Taliayaya/4-bit-alu/alu.kicad_pcb

## KiCad design alu.kicad_pcb (2026-04-29)

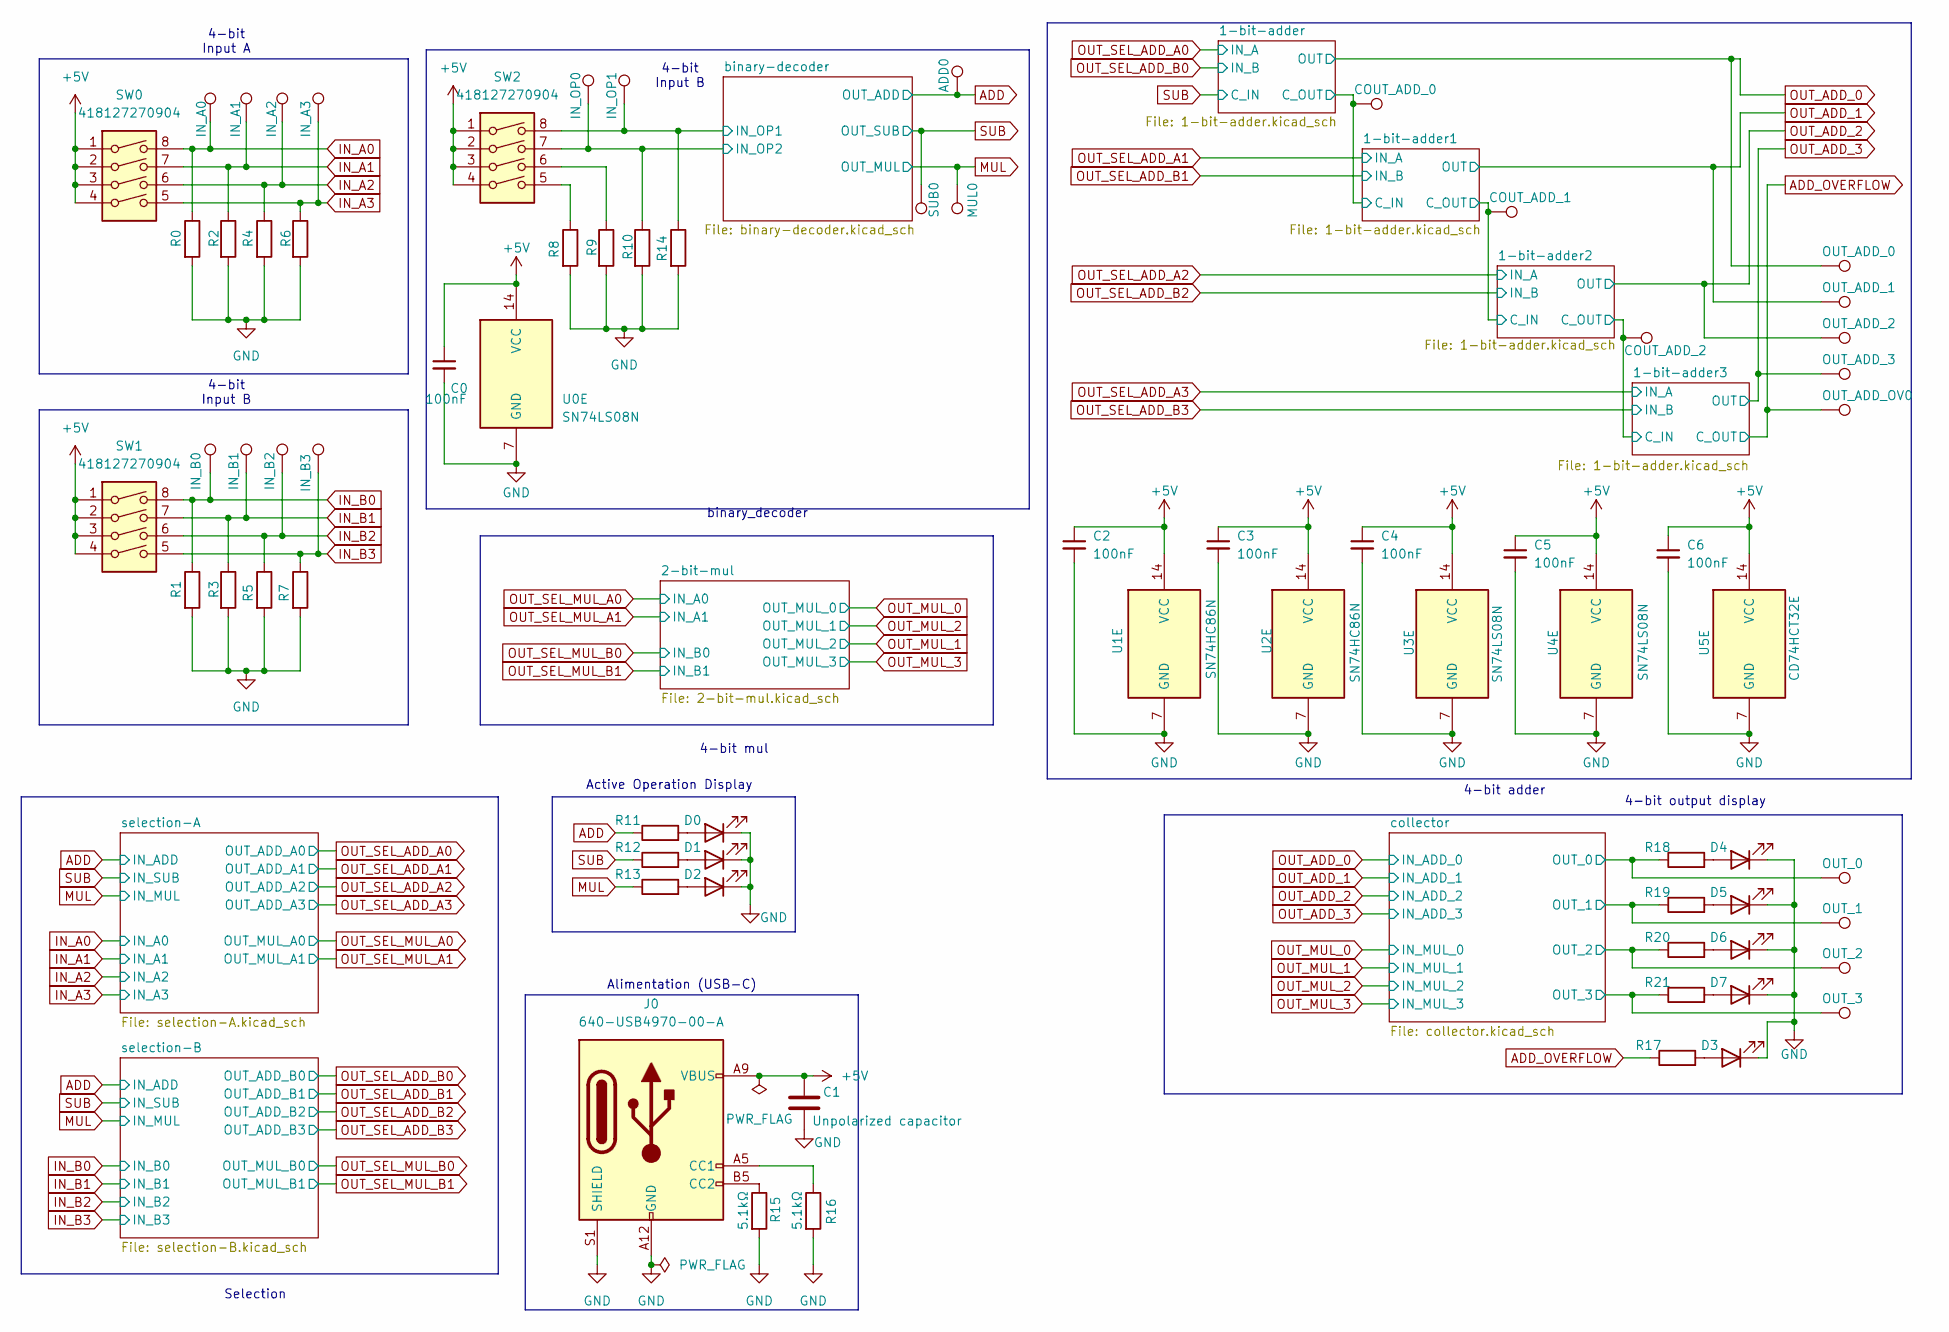
[picture p1: schematic alu.kicad_sch, ALU 4-bit]

Parts:
ADD0: TestPoint; TestPoint_THTPad_D1.0mm_Drill0.5mm
C0, C2, C3, C4, C5, C6: 100nF; C_0603_1608Metric
C1: 10uF; C_0603_1608Metric_Pad1.08x0.95mm_HandSolder
COUT_ADD_0, COUT_ADD_1, COUT_ADD_2: TestPoint; TestPoint_THTPad_D1.0mm_Drill0.5mm
D0, D1, D2, D3, D4, D5, D6, D7: 150080RS75000; LED_0805_2012Metric
IN_A0, IN_A1, IN_A2, IN_A3: TestPoint; TestPoint_THTPad_D1.0mm_Drill0.5mm
IN_B0, IN_B1, IN_B2, IN_B3: TestPoint; TestPoint_THTPad_D1.0mm_Drill0.5mm
IN_OP0, IN_OP1: TestPoint; TestPoint_THTPad_D1.0mm_Drill0.5mm
J0: 640-USB4970-00-A; USB_C_Receptacle_GCT_USB4125-xx-x_6P_TopMnt_Horizontal
MUL0: TestPoint; TestPoint_THTPad_D1.0mm_Drill0.5mm
OUT_0, OUT_1, OUT_2, OUT_3: TestPoint; TestPoint_THTPad_D1.0mm_Drill0.5mm
OUT_ADD_0, OUT_ADD_1, OUT_ADD_2, OUT_ADD_3: TestPoint; TestPoint_THTPad_D1.0mm_Drill0.5mm
OUT_ADD_OV0: TestPoint; TestPoint_THTPad_D1.0mm_Drill0.5mm
R0, R1, R2, R3, R4, R5, R6, R7, R8, R9, R10, R14: 10kΩ; R_0603_1608Metric_Pad0.98x0.95mm_HandSolder
R11, R12, R13, R17, R18, R19, R20, R21: 220Ω; R_0603_1608Metric_Pad0.98x0.95mm_HandSolder
R15, R16: 5.1kΩ; R_0603_1608Metric_Pad0.98x0.95mm_HandSolder
SUB0: TestPoint; TestPoint_THTPad_D1.0mm_Drill0.5mm
SW0, SW1, SW2: 418127270904; SW_DIP_SPSTx04_Slide_6.7x11.72mm_W7.62mm_P2.54mm_LowProfile
U0, U3, U4: SN74LS08N; DIP-14_W7.62mm_LongPads
U1, U2: SN74HC86N; DIP-14_W7.62mm_LongPads
U5: CD74HCT32E; DIP-14_W7.62mm_LongPads

Connections:
+5V: C0.1, C1.1, C2.1, C3.1, C4.1, C5.1, C6.1, J0.A9 (VBUS), J0.B9 (VBUS), SW0.1, SW0.2, SW0.3, SW0.4, SW1.1, SW1.2, SW1.3, SW1.4, SW2.1, SW2.2, SW2.3, SW2.4, U0.14 (VCC), U1.14 (VCC), U2.14 (VCC), U3.14 (VCC), U4.14 (VCC), U5.14 (VCC); also elsewhere on the board
/1-bit-adder1/C_OUT: COUT_ADD_1.1, U5.6; also elsewhere on the board
/1-bit-adder2/C_OUT: COUT_ADD_2.1, U2.13, U3.12, U5.8
/1-bit-adder/C_OUT: COUT_ADD_0.1, U0.12, U1.13; also elsewhere on the board
/binary-decoder/IN_OP1: IN_OP1.1, R14.1, SW2.8; also elsewhere on the board
/binary-decoder/IN_OP2: IN_OP0.1, R10.1, SW2.7; also elsewhere on the board
/collector/OUT_0: OUT_0.1, R18.1; also elsewhere on the board
/collector/OUT_1: OUT_1.1, R19.1; also elsewhere on the board
/collector/OUT_2: OUT_2.1, R20.1; also elsewhere on the board
/collector/OUT_3: OUT_3.1, R21.1; also elsewhere on the board
ADD: ADD0.1, R11.1; also elsewhere on the board
ADD_OVERFLOW: OUT_ADD_OV0.1, R17.1, U5.11
GND: C0.2, C1.2, C2.2, C3.2, C4.2, C5.2, C6.2, D0.1 (K), D1.1 (K), D2.1 (K), D3.1 (K), D4.1 (K), D5.1 (K), D6.1 (K), D7.1 (K), J0.A12 (GND), J0.B12 (GND), J0.S1 (SHIELD), R0.2, R1.2, R2.2, R3.2, R4.2, R5.2, R6.2, R7.2, R8.2, R9.2, R10.2, R14.2, R15.2, R16.2, U0.7 (GND), U1.7 (GND), U2.7 (GND), U3.7 (GND), U4.7 (GND), U5.7 (GND); also elsewhere on the board
IN_A0: IN_A0.1, R0.1, SW0.8; also elsewhere on the board
IN_A1: IN_A1.1, R2.1, SW0.7; also elsewhere on the board
IN_A2: IN_A2.1, R4.1, SW0.6; also elsewhere on the board
IN_A3: IN_A3.1, R6.1, SW0.5; also elsewhere on the board
IN_B0: IN_B0.1, R1.1, SW1.8; also elsewhere on the board
IN_B1: IN_B1.1, R3.1, SW1.7; also elsewhere on the board
IN_B2: IN_B2.1, R5.1, SW1.6; also elsewhere on the board
IN_B3: IN_B3.1, R7.1, SW1.5; also elsewhere on the board
MUL: MUL0.1, R13.1; also elsewhere on the board
unnamed: D0.2 (A), R11.2
unnamed: D1.2 (A), R12.2
unnamed: D2.2 (A), R13.2
unnamed: D3.2 (A), R17.2
unnamed: D4.2 (A), R18.2
unnamed: D5.2 (A), R19.2
unnamed: D6.2 (A), R20.2
unnamed: D7.2 (A), R21.2
unnamed: J0.A5 (CC1), R16.1
unnamed: J0.B5 (CC2), R15.1
unnamed: R8.1, SW2.5
unnamed: R9.1, SW2.6
unnamed: U0.8, U5.4
unnamed: U0.11, U5.5
unnamed: U0.13, U1.8, U1.12
unnamed: U2.8, U2.12, U3.13
unnamed 48: U5.9; also elsewhere on the board
unnamed 49: U5.10; also elsewhere on the board
unnamed: U3.8, U5.12
unnamed: U3.11, U5.13
OUT_ADD_0: OUT_ADD_0.1; also elsewhere on the board
OUT_ADD_1: OUT_ADD_1.1, U1.11; also elsewhere on the board
OUT_ADD_2: OUT_ADD_2.1; also elsewhere on the board
OUT_ADD_3: OUT_ADD_3.1, U2.11; also elsewhere on the board
OUT_SEL_ADD_A1: U0.9, U1.9; also elsewhere on the board
OUT_SEL_ADD_A3: U2.9, U3.9; also elsewhere on the board
OUT_SEL_ADD_B1: U0.10, U1.10; also elsewhere on the board
OUT_SEL_ADD_B3: U2.10, U3.10; also elsewhere on the board
SUB: R12.1, SUB0.1; also elsewhere on the board

Notes on the sheet:
Alimentation (USB-C)
4-bit output display
Active Operation Display
4-bit Input A
Selection
4-bit Input B
4-bit mul
binary_decoder
4-bit adder

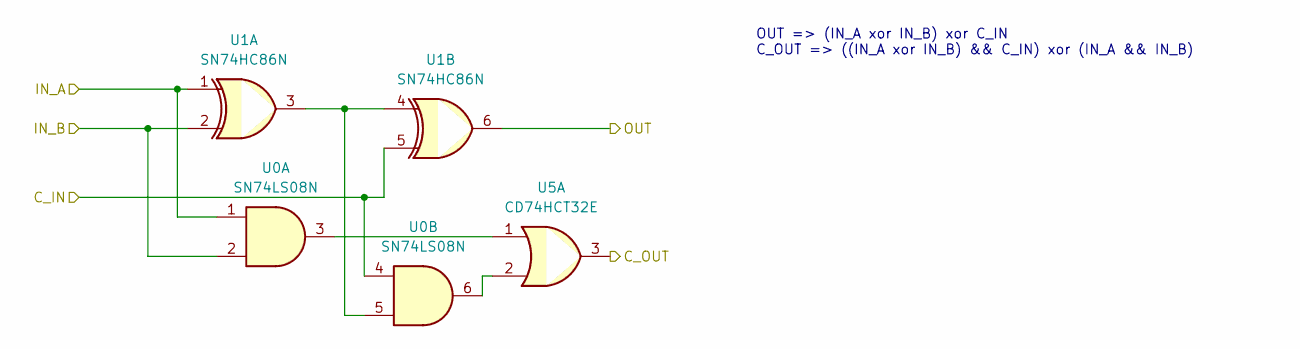
[picture p2: schematic 1-bit-adder.kicad_sch]

Parts:
U0: SN74LS08N; DIP-14_W7.62mm_LongPads
U1: SN74HC86N; DIP-14_W7.62mm_LongPads
U5: CD74HCT32E; DIP-14_W7.62mm_LongPads

Connections:
/1-bit-adder1/C_OUT: U5.6; also elsewhere on the board
/1-bit-adder2/C_OUT: U5.8; also elsewhere on the board
/1-bit-adder/C_OUT: U0.12, U1.13, U5.3; also elsewhere on the board
ADD_OVERFLOW: U5.11; also elsewhere on the board
unnamed: U0.3, U5.1
unnamed: U0.5, U1.3, U1.4
unnamed: U0.6, U5.2
unnamed: U0.8, U5.4
unnamed: U0.11, U5.5
unnamed: U0.13, U1.8, U1.12
unnamed 48: U5.9; also elsewhere on the board
unnamed 49: U5.10; also elsewhere on the board
unnamed 50: U5.12; also elsewhere on the board
unnamed 51: U5.13; also elsewhere on the board
OUT_ADD_0: U1.6; also elsewhere on the board
OUT_ADD_1: U1.11; also elsewhere on the board
OUT_SEL_ADD_A0: U0.1, U1.1; also elsewhere on the board
OUT_SEL_ADD_A1: U0.9, U1.9; also elsewhere on the board
OUT_SEL_ADD_B0: U0.2, U1.2; also elsewhere on the board
OUT_SEL_ADD_B1: U0.10, U1.10; also elsewhere on the board
SUB: U0.4, U1.5; also elsewhere on the board

Notes on the sheet:
OUT => (IN_A xor IN_B) xor C_IN C_OUT => ((IN_A xor IN_B) && C_IN) xor (IN_A && IN_B)

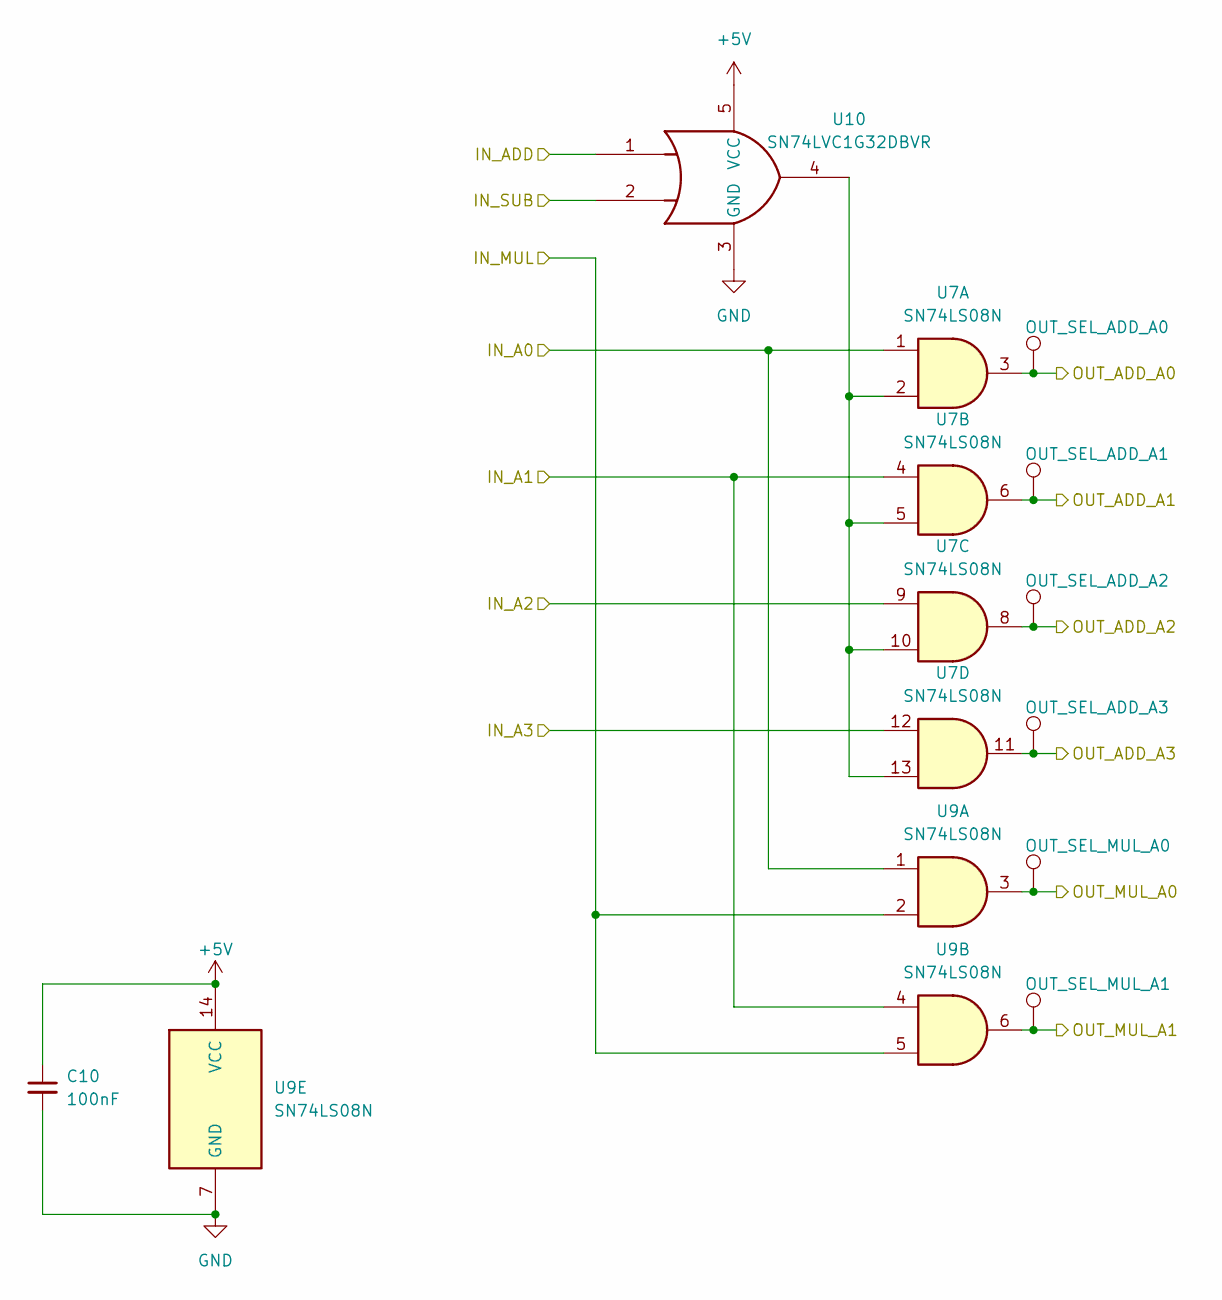
[picture p3: schematic selection-A.kicad_sch]

Parts:
C10: 100nF; C_0603_1608Metric
OUT_SEL_ADD_A0, OUT_SEL_ADD_A1, OUT_SEL_ADD_A2, OUT_SEL_ADD_A3: TestPoint; TestPoint_THTPad_D1.0mm_Drill0.5mm
OUT_SEL_MUL_A0, OUT_SEL_MUL_A1: TestPoint; TestPoint_THTPad_D1.0mm_Drill0.5mm
U7, U9: SN74LS08N; DIP-14_W7.62mm_LongPads
U10: SN74LVC1G32DBVR; SOT-23-5_HandSoldering

Connections:
+5V: C10.1, U9.14 (VCC), U10.5 (VCC); also elsewhere on the board
ADD: U10.1; also elsewhere on the board
GND: C10.2, U9.7 (GND), U10.3 (GND); also elsewhere on the board
IN_A0: U7.1, U9.1; also elsewhere on the board
IN_A1: U7.4, U9.4; also elsewhere on the board
IN_A2: U7.9; also elsewhere on the board
IN_A3: U7.12; also elsewhere on the board
MUL: U9.2, U9.5; also elsewhere on the board
unnamed: U7.2, U7.5, U7.10, U7.13, U10.4
OUT_SEL_ADD_A0: OUT_SEL_ADD_A0.1, U7.3; also elsewhere on the board
OUT_SEL_ADD_A1: OUT_SEL_ADD_A1.1, U7.6; also elsewhere on the board
OUT_SEL_ADD_A2: OUT_SEL_ADD_A2.1, U7.8; also elsewhere on the board
OUT_SEL_ADD_A3: OUT_SEL_ADD_A3.1, U7.11; also elsewhere on the board
OUT_SEL_MUL_A0: OUT_SEL_MUL_A0.1, U9.3; also elsewhere on the board
OUT_SEL_MUL_A1: OUT_SEL_MUL_A1.1, U9.6; also elsewhere on the board
SUB: U10.2; also elsewhere on the board

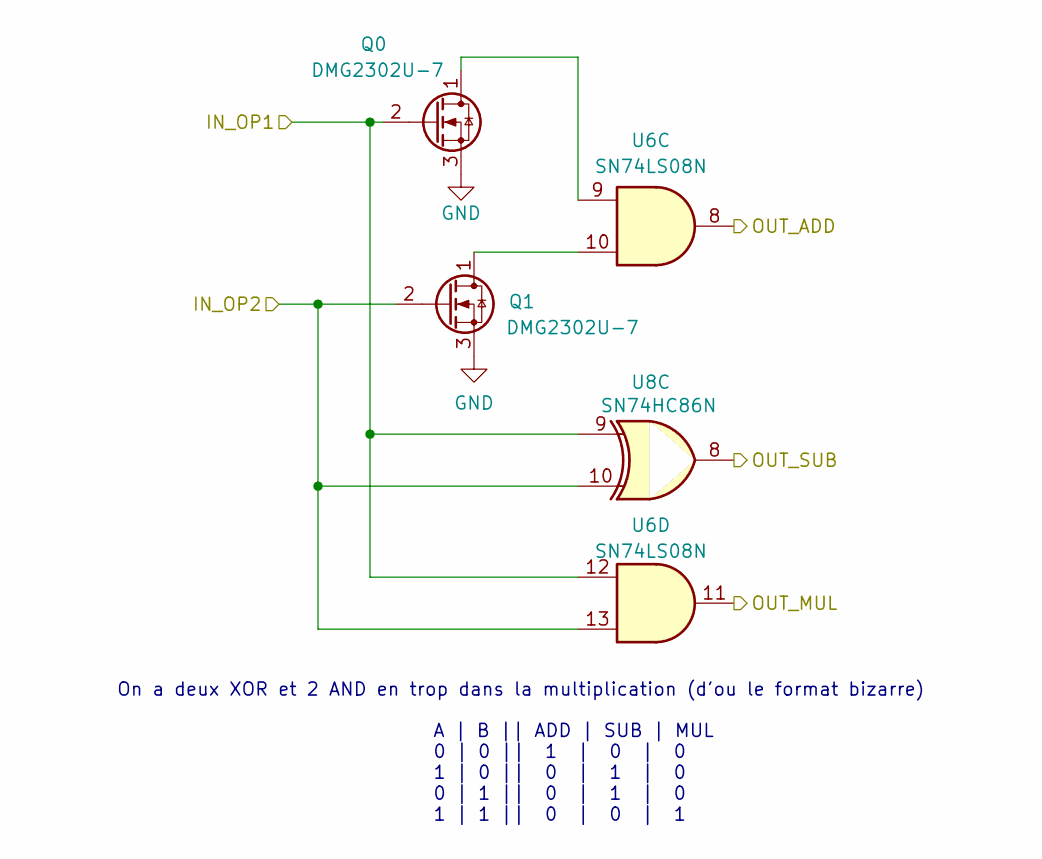
[picture p4: schematic binary-decoder.kicad_sch]

Parts:
Q0, Q1: DMG2302U-7; SOT-23-3
U6: SN74LS08N; DIP-14_W7.62mm_LongPads
U8: SN74HC86N; DIP-14_W7.62mm_LongPads

Connections:
/binary-decoder/IN_OP1: Q0.2 (G), U6.12, U8.9; also elsewhere on the board
/binary-decoder/IN_OP2: Q1.2 (G), U6.13, U8.10; also elsewhere on the board
ADD: U6.8; also elsewhere on the board
GND: Q0.3 (S), Q1.3 (S); also elsewhere on the board
MUL: U6.11; also elsewhere on the board
unnamed 32: Q0.1 (D), U6.9; also elsewhere on the board
unnamed 33: Q1.1 (D), U6.10; also elsewhere on the board
SUB: U8.8; also elsewhere on the board

Notes on the sheet:
A | B || ADD | SUB | MUL 0 | 0 || 1 | 0 | 0 1 | 0 || 0 | 1 | 0 0 | 1 || 0 | 1 | 0 1 | 1 || 0 | 0 | 1
On a deux XOR et 2 AND en trop dans la multiplication (d'ou le format bizarre)

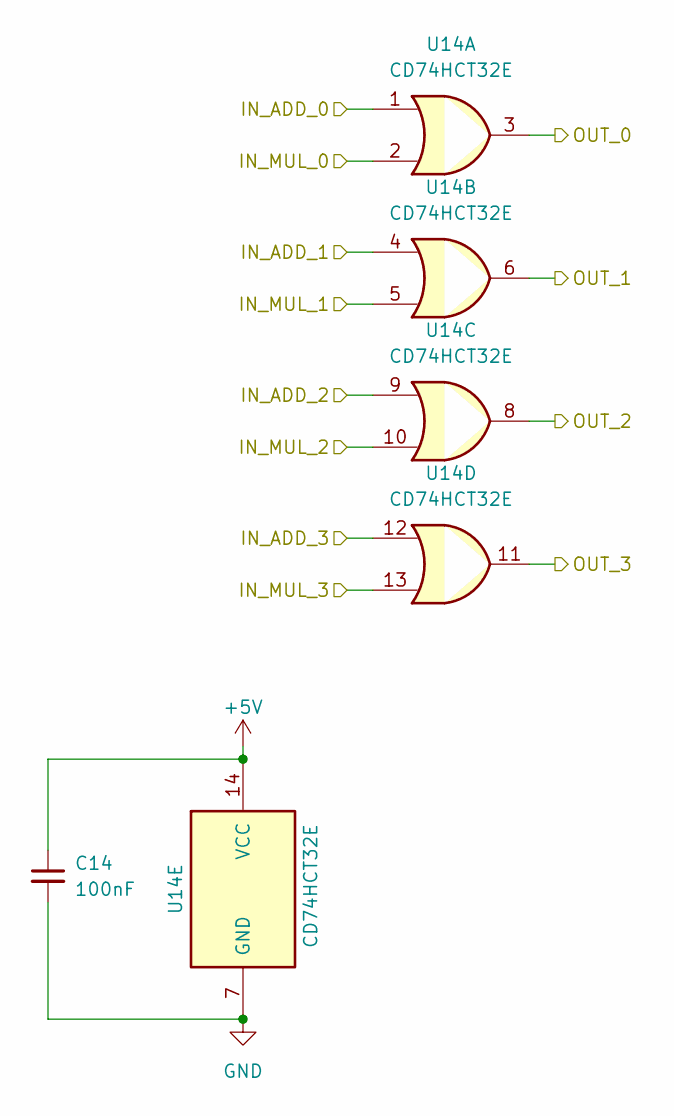
[picture p5: schematic collector.kicad_sch]

Parts:
C14: 100nF; C_0603_1608Metric
U14: CD74HCT32E; DIP-14_W7.62mm_LongPads

Connections:
+5V: C14.1, U14.14 (VCC); also elsewhere on the board
/collector/OUT_0: U14.3; also elsewhere on the board
/collector/OUT_1: U14.6; also elsewhere on the board
/collector/OUT_2: U14.8; also elsewhere on the board
/collector/OUT_3: U14.11; also elsewhere on the board
GND: C14.2, U14.7 (GND); also elsewhere on the board
OUT_ADD_0: U14.1; also elsewhere on the board
OUT_ADD_1: U14.4; also elsewhere on the board
OUT_ADD_2: U14.9; also elsewhere on the board
OUT_ADD_3: U14.12; also elsewhere on the board
OUT_MUL_0: U14.2; also elsewhere on the board
OUT_MUL_1: U14.5; also elsewhere on the board
OUT_MUL_2: U14.10; also elsewhere on the board
OUT_MUL_3: U14.13; also elsewhere on the board

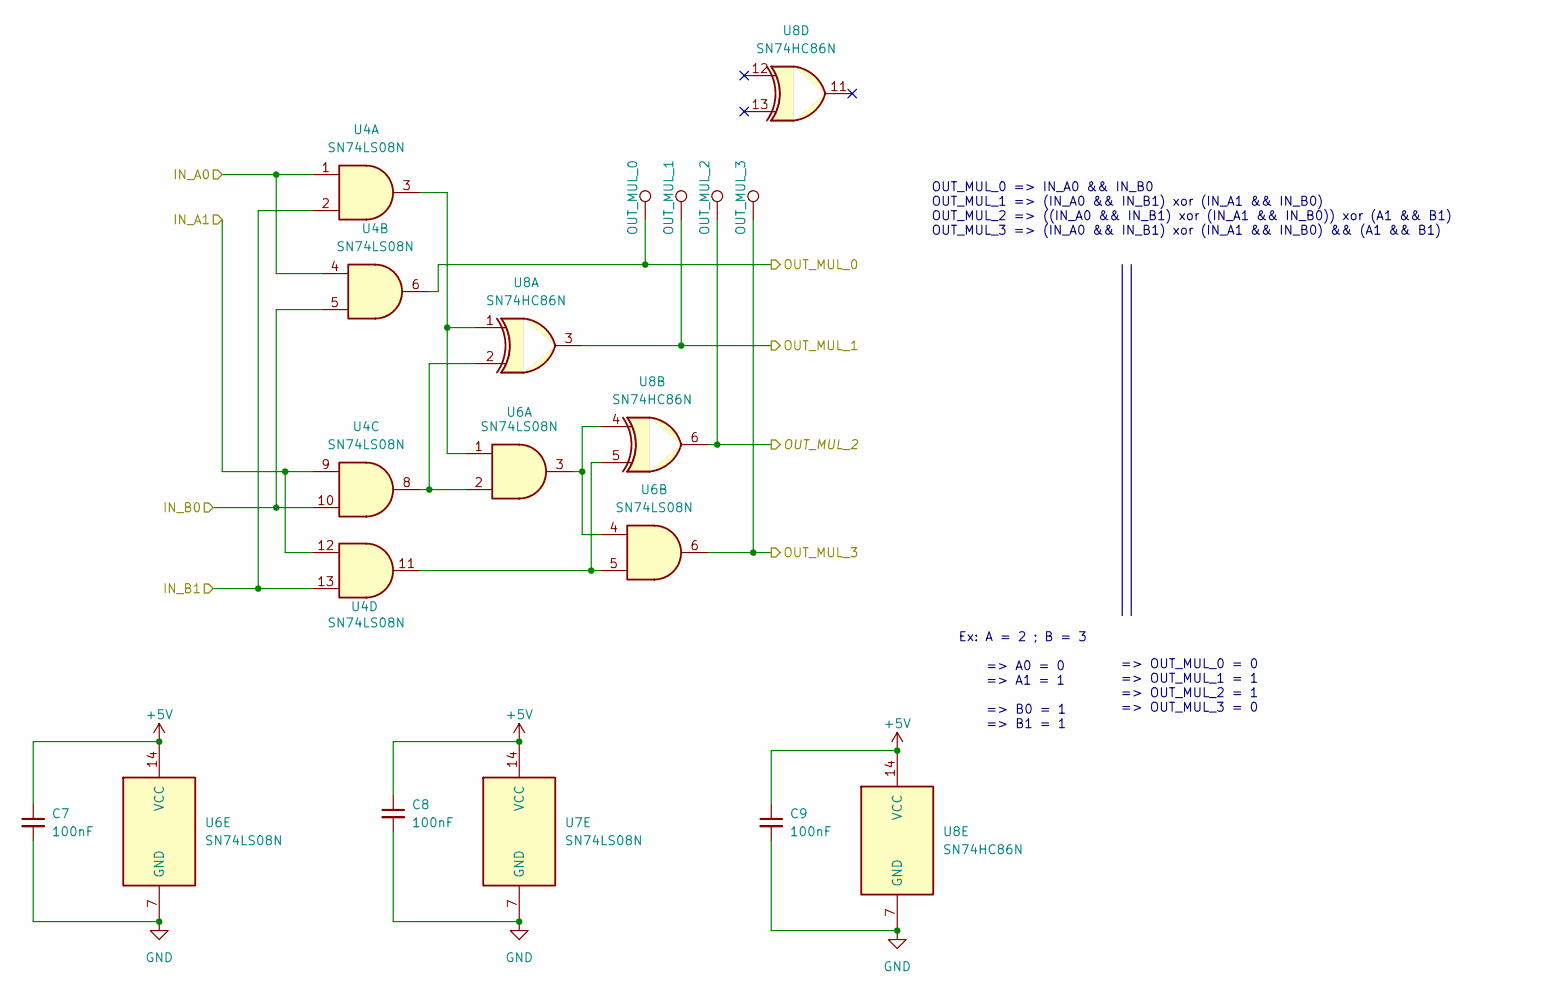
[picture p6: schematic 2-bit-mul.kicad_sch]

Parts:
C7, C8, C9: 100nF; C_0603_1608Metric
OUT_MUL_0, OUT_MUL_1, OUT_MUL_2, OUT_MUL_3: TestPoint; TestPoint_THTPad_D1.0mm_Drill0.5mm
U4, U6, U7: SN74LS08N; DIP-14_W7.62mm_LongPads
U8: SN74HC86N; DIP-14_W7.62mm_LongPads

Connections:
+5V: C7.1, C8.1, C9.1, U6.14 (VCC), U7.14 (VCC), U8.14 (VCC); also elsewhere on the board
GND: C7.2, C8.2, C9.2, U6.7 (GND), U7.7 (GND), U8.7 (GND); also elsewhere on the board
unnamed: U4.3, U6.1, U8.1
unnamed: U4.8, U6.2, U8.2
unnamed: U4.11, U6.5, U8.5
unnamed: U6.3, U6.4, U8.4
OUT_MUL_0: OUT_MUL_0.1, U4.6; also elsewhere on the board
OUT_MUL_1: OUT_MUL_2.1, U8.6; also elsewhere on the board
OUT_MUL_2: OUT_MUL_1.1, U8.3; also elsewhere on the board
OUT_MUL_3: OUT_MUL_3.1, U6.6; also elsewhere on the board
OUT_SEL_MUL_A0: U4.1, U4.4; also elsewhere on the board
OUT_SEL_MUL_A1: U4.9, U4.12; also elsewhere on the board
OUT_SEL_MUL_B0: U4.5, U4.10; also elsewhere on the board
OUT_SEL_MUL_B1: U4.2, U4.13; also elsewhere on the board

Notes on the sheet:
OUT_MUL_0 => IN_A0 && IN_B0 OUT_MUL_1 => (IN_A0 && IN_B1) xor (IN_A1 && IN_B0) OUT_MUL_2 => ((IN_A0 && IN_B1) xor (IN_A1 && IN_B0)) xor (A1 && B1) OUT_MUL_3 => (IN_A0 && IN_B1) xor (IN_A1 && IN_B0) && (A1 && B1)
=> OUT_MUL_0 = 0 => OUT_MUL_1 = 1 => OUT_MUL_2 = 1 => OUT_MUL_3 = 0
Ex: A = 2 ; B = 3 => A0 = 0 => A1 = 1 => B0 = 1 => B1 = 1

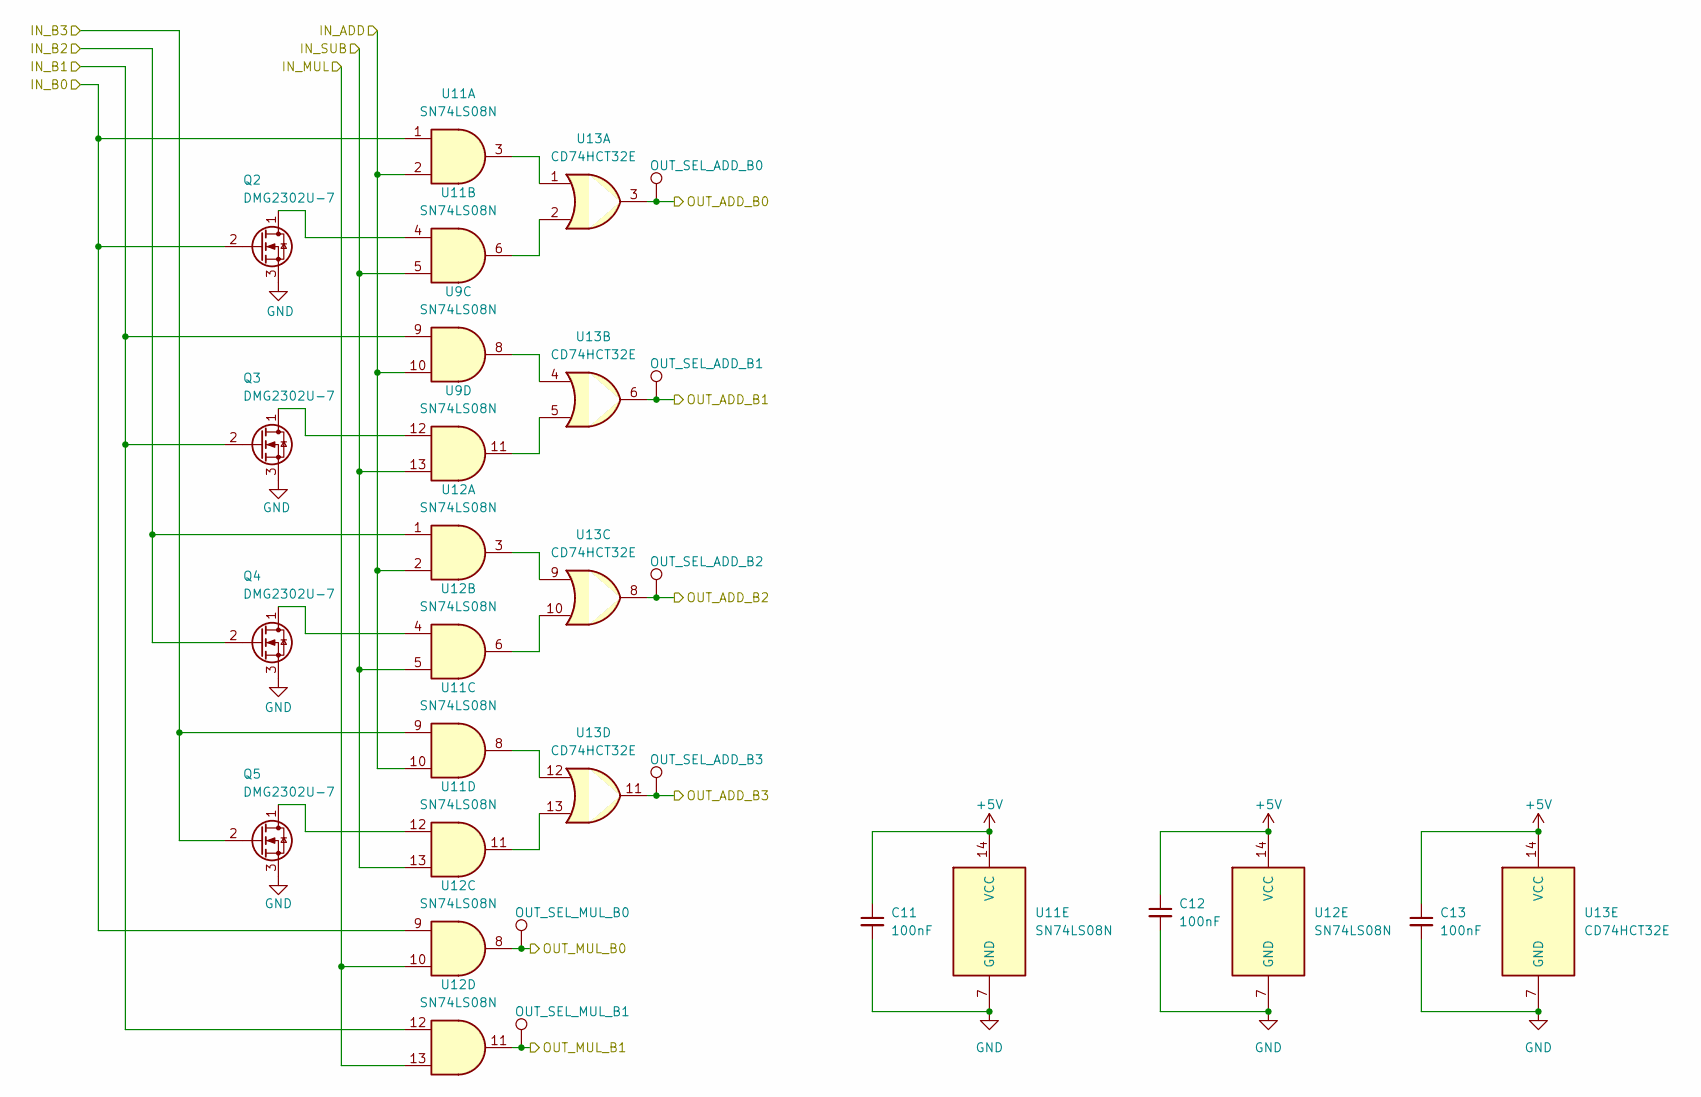
[picture p7: schematic selection-B.kicad_sch]

Parts:
C11, C12, C13: 100nF; C_0603_1608Metric
OUT_SEL_ADD_B0, OUT_SEL_ADD_B1, OUT_SEL_ADD_B2, OUT_SEL_ADD_B3: TestPoint; TestPoint_THTPad_D1.0mm_Drill0.5mm
OUT_SEL_MUL_B0, OUT_SEL_MUL_B1: TestPoint; TestPoint_THTPad_D1.0mm_Drill0.5mm
Q2, Q3, Q4, Q5: DMG2302U-7; SOT-23-3
U9, U11, U12: SN74LS08N; DIP-14_W7.62mm_LongPads
U13: CD74HCT32E; DIP-14_W7.62mm_LongPads

Connections:
+5V: C11.1, C12.1, C13.1, U11.14 (VCC), U12.14 (VCC), U13.14 (VCC); also elsewhere on the board
ADD: U9.10, U11.2, U11.10, U12.2; also elsewhere on the board
GND: C11.2, C12.2, C13.2, Q2.3 (S), Q3.3 (S), Q4.3 (S), Q5.3 (S), U11.7 (GND), U12.7 (GND), U13.7 (GND); also elsewhere on the board
IN_B0: Q2.2 (G), U11.1, U12.9; also elsewhere on the board
IN_B1: Q3.2 (G), U9.9, U12.12; also elsewhere on the board
IN_B2: Q4.2 (G), U12.1; also elsewhere on the board
IN_B3: Q5.2 (G), U11.9; also elsewhere on the board
MUL: U12.10, U12.13; also elsewhere on the board
unnamed 34: Q2.1 (D), U11.4; also elsewhere on the board
unnamed 35: Q3.1 (D), U9.12; also elsewhere on the board
unnamed 36: Q4.1 (D), U12.4; also elsewhere on the board
unnamed 37: Q5.1 (D), U11.12; also elsewhere on the board
unnamed: U11.3, U13.1
unnamed: U11.6, U13.2
unnamed: U11.8, U13.12
unnamed: U11.11, U13.13
unnamed: U12.3, U13.9
unnamed: U12.6, U13.10
unnamed: U9.8, U13.4
unnamed: U9.11, U13.5
OUT_SEL_ADD_B0: OUT_SEL_ADD_B0.1, U13.3; also elsewhere on the board
OUT_SEL_ADD_B1: OUT_SEL_ADD_B1.1, U13.6; also elsewhere on the board
OUT_SEL_ADD_B2: OUT_SEL_ADD_B2.1, U13.8; also elsewhere on the board
OUT_SEL_ADD_B3: OUT_SEL_ADD_B3.1, U13.11; also elsewhere on the board
OUT_SEL_MUL_B0: OUT_SEL_MUL_B0.1, U12.8; also elsewhere on the board
OUT_SEL_MUL_B1: OUT_SEL_MUL_B1.1, U12.11; also elsewhere on the board
SUB: U9.13, U11.5, U11.13, U12.5; also elsewhere on the board

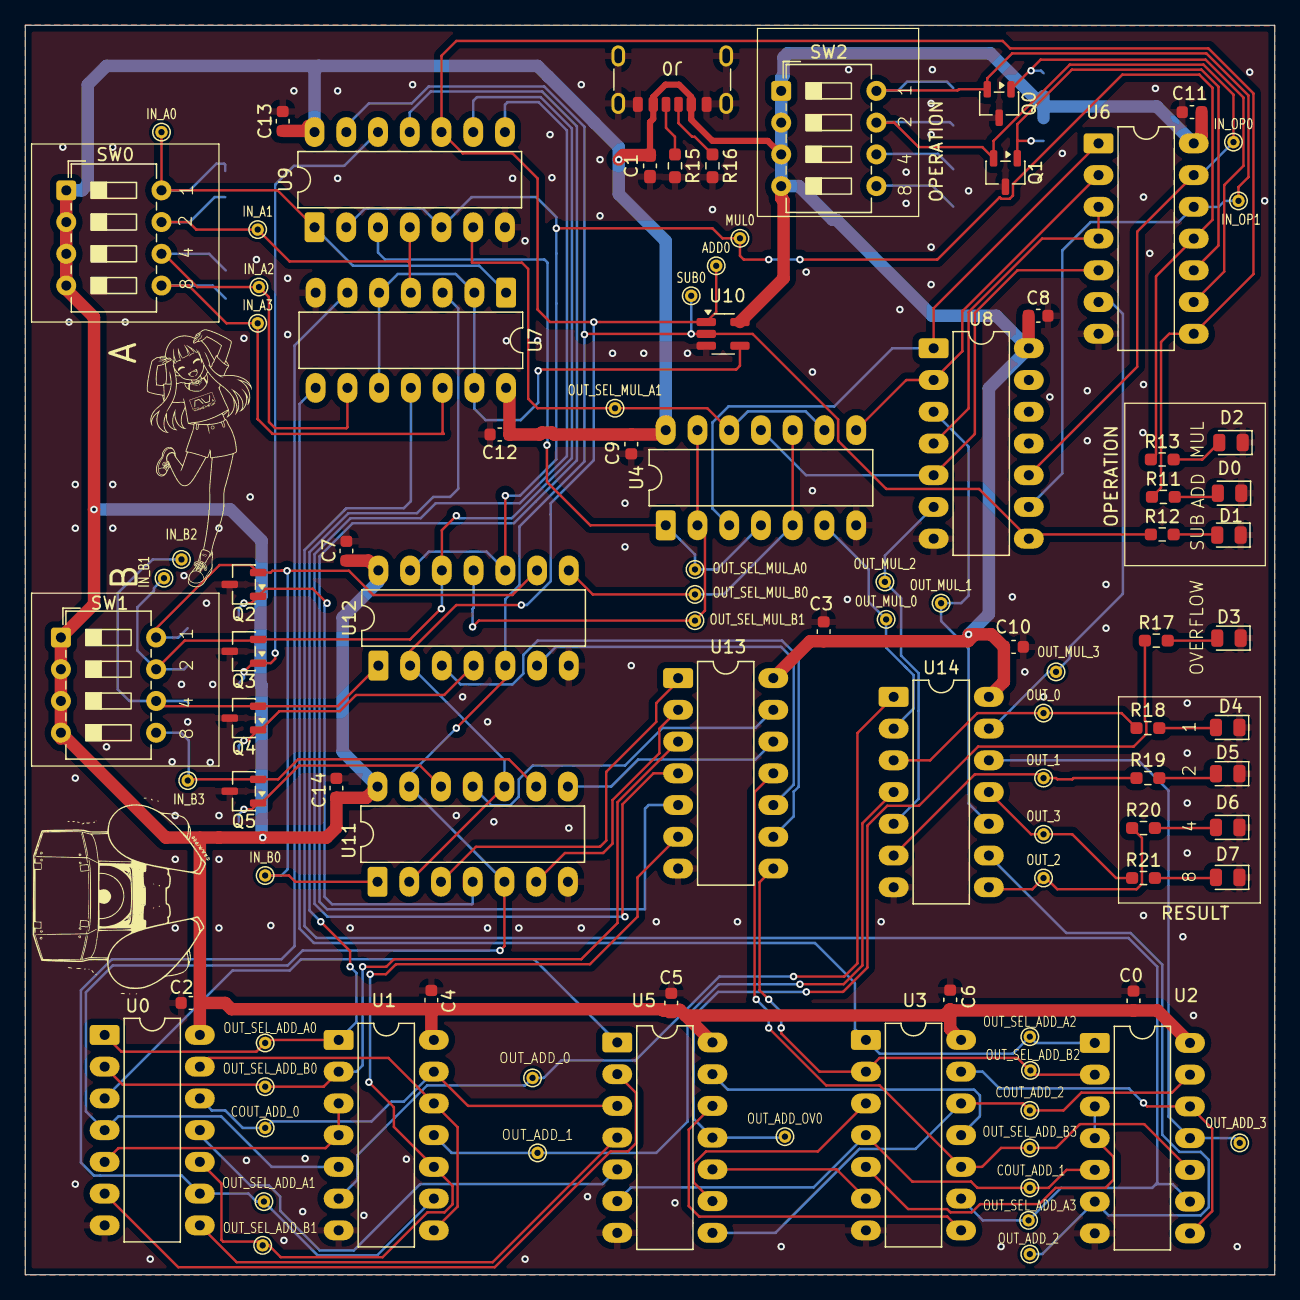
[picture p8: board alu.kicad_pcb from above]

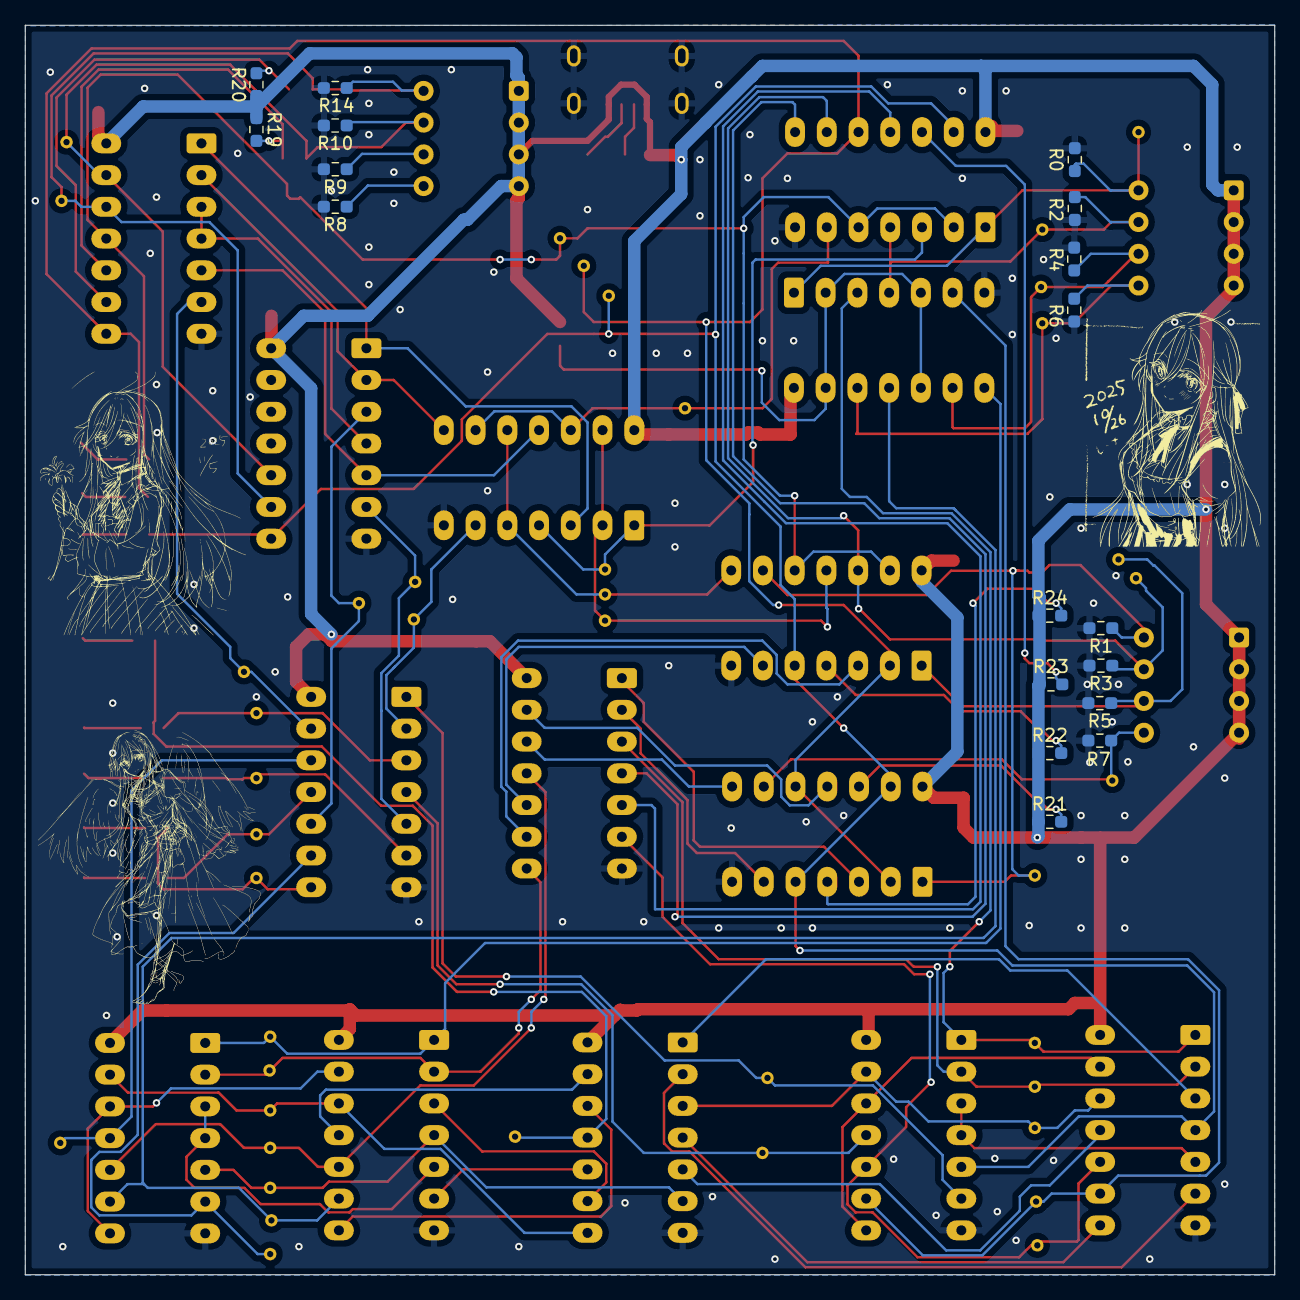
[picture p9: board alu.kicad_pcb from below]

Board: 2 copper layers, 100.0 x 100.0 mm, 117 parts (18 on the bottom side), 86 nets.

Other parts of the board:
R19#2, R20#2, R21#2, R22, R23, R24: 10k; R_0603_1608Metric_Pad0.98x0.95mm_HandSolder

Their connections:
+5V: R19#2.1, R20#2.1, R21#2.1, R22.1, R23.1, R24.1; also elsewhere on the board
unnamed 32: R20#2.2; also elsewhere on the board
unnamed 33: R19#2.2; also elsewhere on the board
unnamed 34: R24.2; also elsewhere on the board
unnamed 35: R23.2; also elsewhere on the board
unnamed 36: R22.2; also elsewhere on the board
unnamed 37: R21#2.2; also elsewhere on the board
