Taliayaya/4-bit-alu/(commit log)

2026-03-02 feat: init
    [alu.kicad_pcb, alu.kicad_sch]
2026-03-02 feat: 4-bit adder
    [1-bit-adder.kicad_sch, alu.kicad_sch]
2026-03-02 feat: working 4-bit adder (normally)
    [1-bit-adder.kicad_sch, alu.kicad_sch]
2026-03-02 feat: mul
    [2-bit-mul.kicad_sch, alu.kicad_sch]
2026-03-03 feat(mul): clean version
    [2-bit-mul.kicad_sch, alu.kicad_sch]
2026-03-03 fix(mul): typo in output label
    [alu.kicad_sch]
2026-03-04 Add stuff and fix rce errors (#1)
    * sync
    * feat: removed ERC errors
    [2-bit-mul.kicad_sch, alu.kicad_sch, binary-decoder.kicad_sch, collector.kicad_sch, selection-A.kicad_sch, selection-B.kicad_sch]
2026-03-04 fix: removed ERC warnings and errors
    [2-bit-mul.kicad_sch, alu.kicad_sch, binary-decoder.kicad_sch, collector.kicad_sch, selection-A.kicad_sch, selection-B.kicad_sch]
2026-03-04 chore: move stuff around
    [2-bit-mul.kicad_sch, alu.kicad_sch]
2026-03-23 feat: NOT to mofset + first batch of footprint
    [1-bit-adder.kicad_sch, 2-bit-mul.kicad_sch, alu.kicad_sch, binary-decoder.kicad_sch, collector.kicad_sch, selection-A.kicad_sch, selection-B.kicad_sch]
2026-03-25 feat: added footprint for mofsets
    [1-bit-adder.kicad_sch, 2-bit-mul.kicad_sch, alu.kicad_sch, binary-decoder.kicad_sch, collector.kicad_sch, selection-A.kicad_sch, selection-B.kicad_sch]
2026-03-25 feat: footprints on gates
    [1-bit-adder.kicad_sch, 2-bit-mul.kicad_sch, alu.kicad_sch, binary-decoder.kicad_sch, collector.kicad_sch, selection-A.kicad_sch, selection-B.kicad_sch]
2026-03-25 fix: save
    [alu.kicad_sch]
2026-03-25 feat: updated footprint
    [alu.kicad_sch]
2026-03-25 feat: usb c
    [alu.kicad_sch]
2026-03-25 fix: updated footprint for mofset to 23-3 and switch to HandSoldering type
    [binary-decoder.kicad_sch, selection-B.kicad_sch]
2026-03-25 fix: forgot to save before commit
    [alu.kicad_sch]
2026-03-25 feat: added capacitor with footprint
    [2-bit-mul.kicad_sch, alu.kicad_sch, collector.kicad_sch, selection-A.kicad_sch, selection-B.kicad_sch]
2026-03-25 fix: merge
    [1-bit-adder.kicad_sch, 2-bit-mul.kicad_sch, alu.kicad_sch, binary-decoder.kicad_sch, collector.kicad_sch, selection-A.kicad_sch, selection-B.kicad_sch]
2026-03-25 fix: fixed capa
    [2-bit-mul.kicad_sch, selection-A.kicad_sch, selection-B.kicad_sch]
2026-03-25 fix: capacitor collector/add
    [alu.kicad_sch, collector.kicad_sch]
2026-03-25 fix: annotation
    [2-bit-mul.kicad_sch, binary-decoder.kicad_sch, selection-A.kicad_sch, selection-B.kicad_sch]
2026-03-25 fix: fixed link of capas
    [2-bit-mul.kicad_sch, selection-A.kicad_sch, selection-B.kicad_sch]
2026-03-25 fix: 0 error 0 warning
    [alu.kicad_sch, collector.kicad_sch]
2026-03-25 fix: change dip switch footprint
    [alu.kicad_pcb, alu.kicad_sch, collector.kicad_sch]
2026-03-25 feat: updated references
    [2-bit-mul.kicad_sch, alu.kicad_sch, binary-decoder.kicad_sch, collector.kicad_sch, selection-A.kicad_sch, selection-B.kicad_sch]
2026-03-26 feat: pcb layout position
    [alu.kicad_pcb, alu.kicad_sch, collector.kicad_sch]
2026-03-28 feat: pcb linkes swicthes
    [alu.kicad_pcb]
2026-03-28 fix: unfilled and refilles ground zone
    [alu.kicad_pcb]
2026-03-28 fix: fixed ground issue
    [alu.kicad_pcb]
2026-03-29 Routed bottom part of the PCB
    [alu.kicad_pcb]
2026-03-30 feat: all connected, 30+ errors remaining
    [alu.kicad_pcb]
2026-03-31 Remove capacitors + change R and C footprints + finish PCB routing
    [2-bit-mul.kicad_sch, alu.kicad_pcb, alu.kicad_sch, collector.kicad_sch, selection-A.kicad_sch, selection-B.kicad_sch]
2026-04-02 feat: kicad 10 to kicad 9
    [1-bit-adder.kicad_sch, 2-bit-mul.kicad_sch, alu.kicad_pcb, alu.kicad_sch, binary-decoder.kicad_sch, collector.kicad_sch, selection-A.kicad_sch, selection-B.kicad_sch]
2026-04-02 fix: reput capas -- where is my gift?
    [1-bit-adder.kicad_sch, 2-bit-mul.kicad_sch, alu.kicad_sch, binary-decoder.kicad_sch, collector.kicad_sch, selection-A.kicad_sch, selection-B.kicad_sch]
2026-04-02 feat: missing pull up
    [alu.kicad_sch, binary-decoder.kicad_sch, selection-B.kicad_sch]
2026-04-02 fix: updated pcb with capas
    [alu.kicad_pcb]
2026-04-02 feat(pcb): pull up and 1mm 5v and 0 error/warning
    [alu.kicad_pcb]
2026-04-02 feat: multiplier schema
    [2-bit-mul.kicad_sch, alu.kicad_sch, binary-decoder.kicad_sch, selection-B.kicad_sch]
2026-04-02 fix: added binary table of adder
    [1-bit-adder.kicad_sch]
2026-04-02 feat: added op led
    [1-bit-adder.kicad_sch, 2-bit-mul.kicad_sch, alu.kicad_pcb, alu.kicad_sch, binary-decoder.kicad_sch, collector.kicad_sch, selection-A.kicad_sch, selection-B.kicad_sch]
2026-04-02 feat: basic silk
    [alu.kicad_pcb]
2026-04-28 feat: added point_tests + fixed wrong footprint for switch + added anime girl
    [2-bit-mul.kicad_sch, alu.kicad_pcb, alu.kicad_sch, binary-decoder.kicad_sch, collector.kicad_sch, selection-A.kicad_sch, selection-B.kicad_sch]
2026-04-28 fix: typos
    [alu.kicad_pcb]
2026-04-29 chore: changed R and C ref to passive value
    [2-bit-mul.kicad_sch, alu.kicad_sch, collector.kicad_sch, selection-A.kicad_sch, selection-B.kicad_sch]
2026-04-29 fix: added datasheets
    [2-bit-mul.kicad_sch, alu.kicad_sch, binary-decoder.kicad_sch, collector.kicad_sch, selection-A.kicad_sch, selection-B.kicad_sch]
2026-04-29 fix: chores pcb
    [alu.kicad_pcb]
2026-04-29 fix: fix
    [alu.kicad_pcb]
2026-04-29 feat: v1
    [alu.kicad_pcb]
